wohali/sy99_8mbex/Docs/Schematic v1.1.png

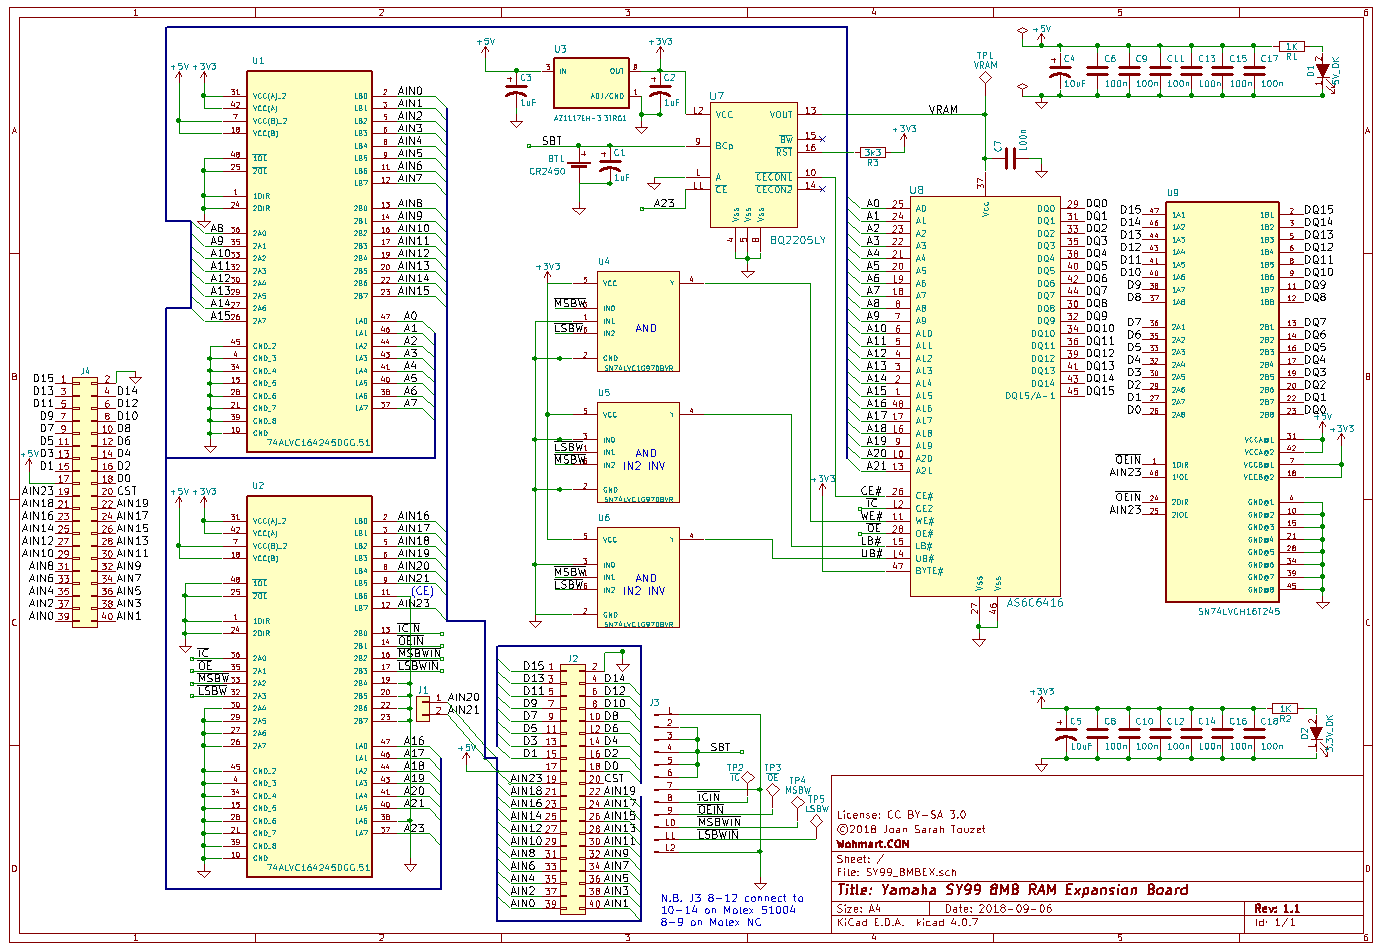
Docs/Schematic v1.1.png
