wohali/sy99_8mbex/Docs/Schematic v1.1.pdf

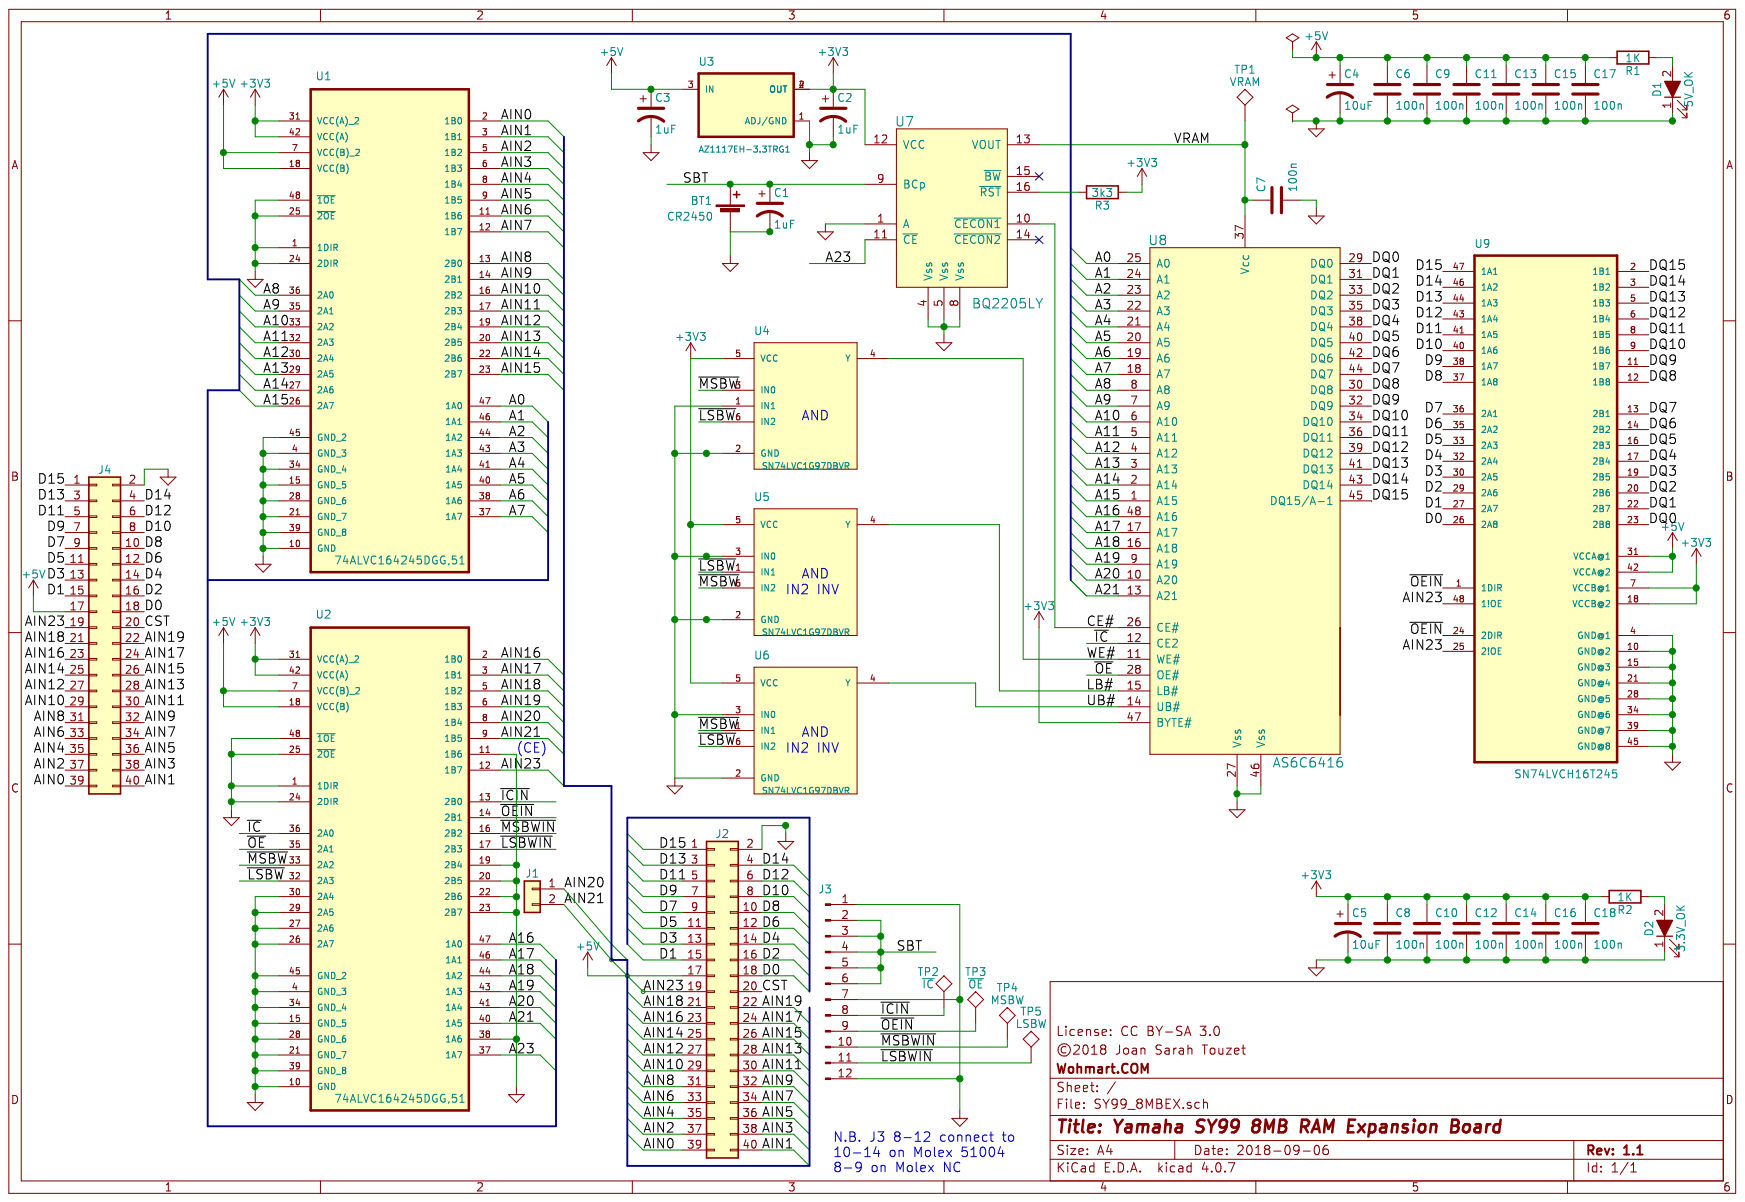
[picture p2: page 1]
