wohali/sy99_8mbex/SY99_8MBEX.kicad_pcb

## KiCad design SY99_8MBEX.kicad_pcb (2018-09-15)

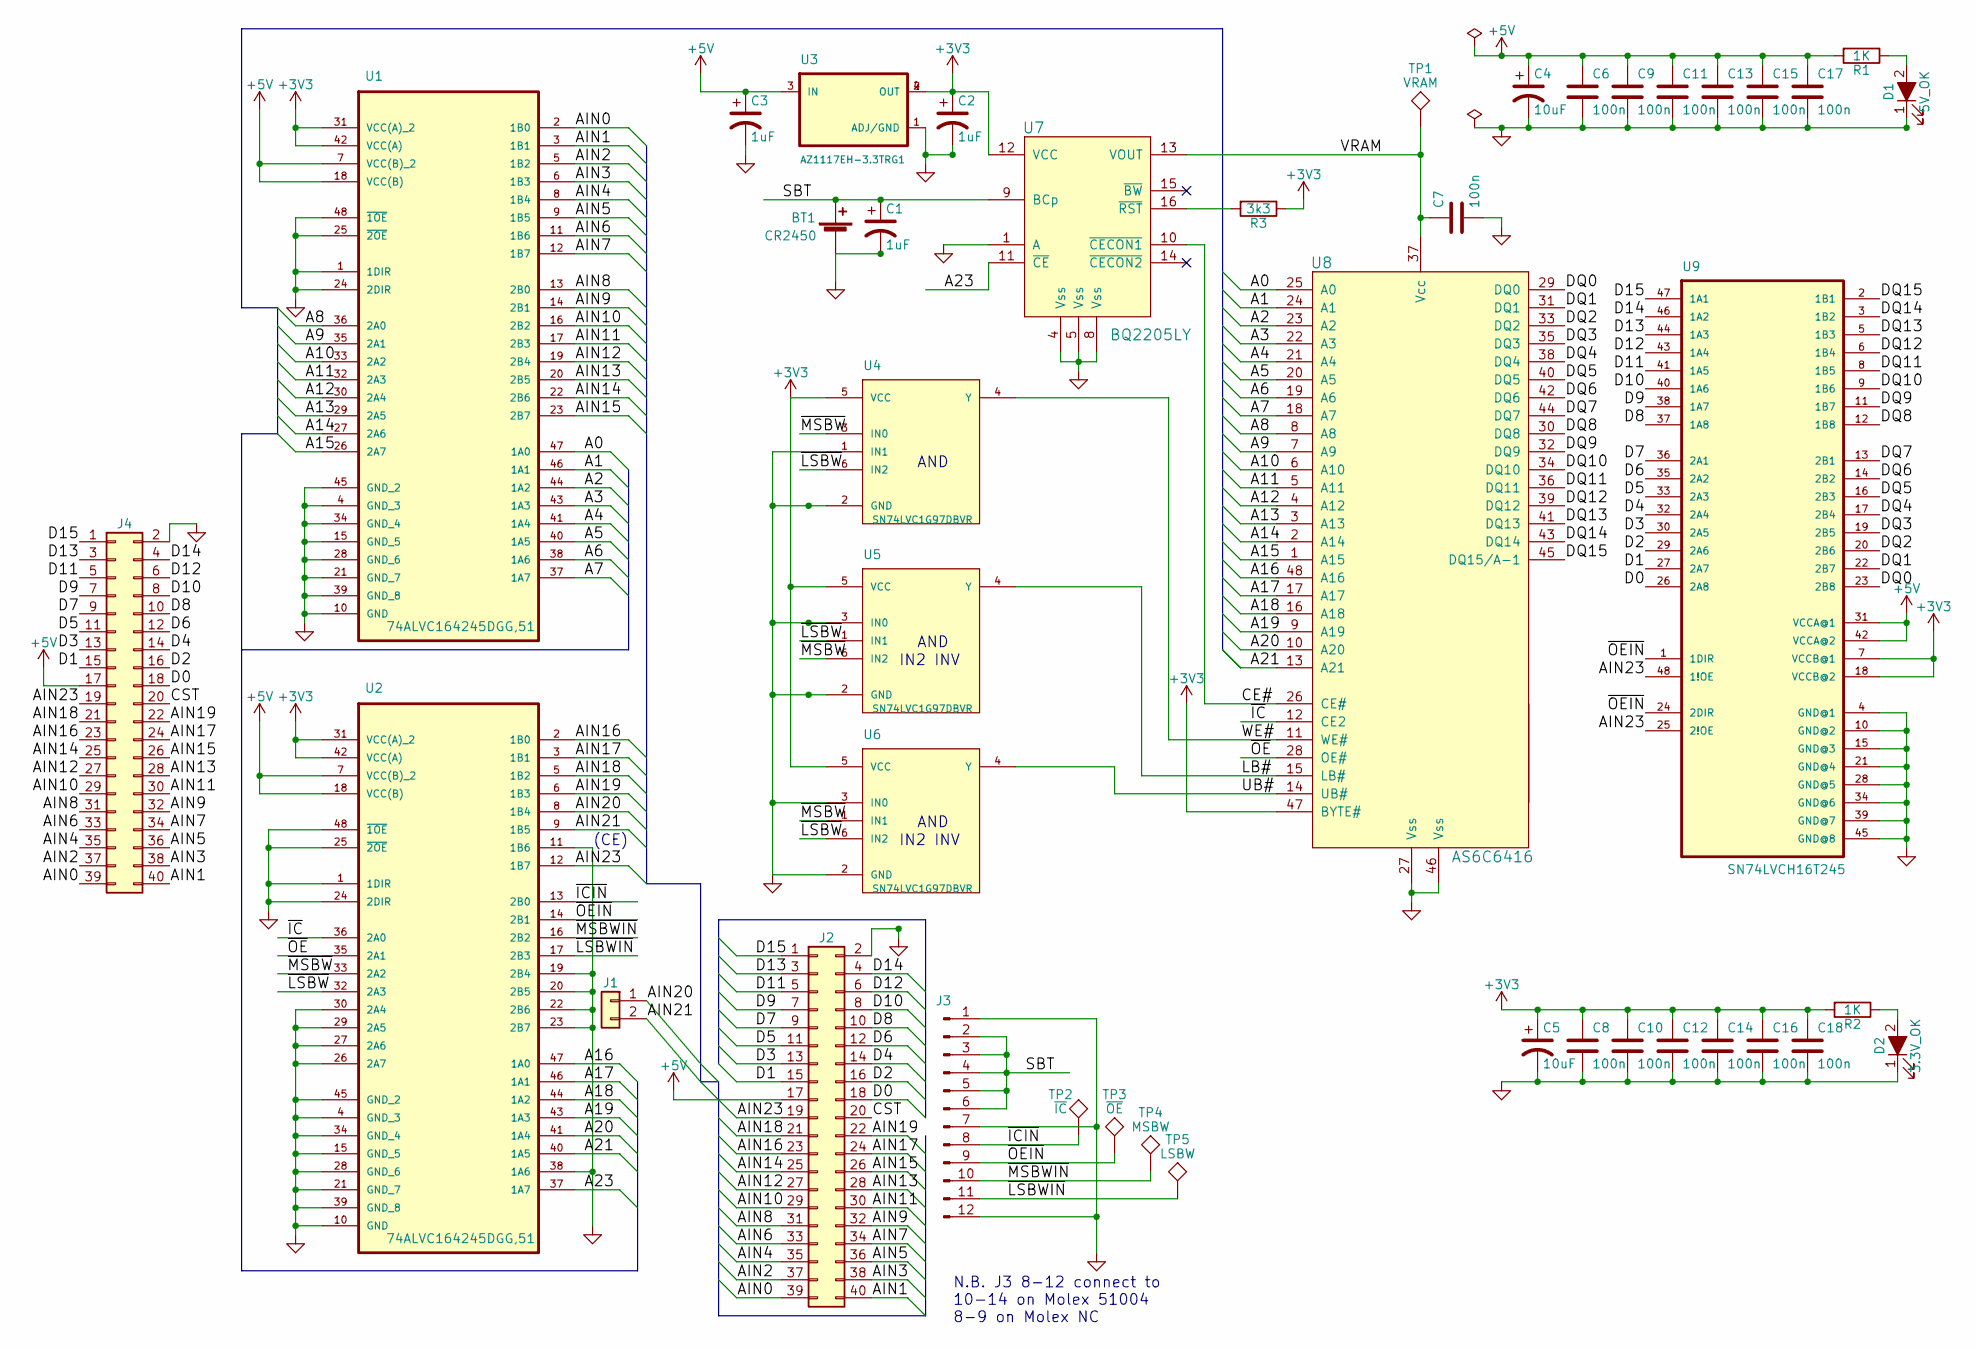
[picture p3: schematic SY99_8MBEX.sch, Yamaha SY99 8MB RAM Expansion Board]

Parts:
BT1: CR2450; Battery_Holder_Coin_2032_BS-7
C1, C2, C3: 1uF; CP_Tantalum_Case-A_EIA-3216-18_Reflow
C4, C5: 10uF; CP_Tantalum_Case-A_EIA-3216-18_Reflow
C6, C7, C8, C9, C10, C11, C12, C13, C14, C15, C16, C17, C18: 100n; C_0805_HandSoldering
D1: 5V_OK; LED_D5.0mm
D2: 3.3V_OK; LED_D5.0mm
J1: Conn_01x02; Pin_Header_Angled_1x02_Pitch2.54mm
J2: Conn_02x20_Odd_Even; Socket_Strip_Straight_2x20_Pitch2.54mm_10.30Wide_SMD
J3: Conn_01x12_Male; Pin_Header_Straight_1x12_Pitch2.54mm
J4: Conn_02x20_Odd_Even; Pin_Header_Straight_2x20_Pitch2.54mm_10.30Wide_SMD
R1, R2: 1K; R_0805_HandSoldering
R3: 3k3; R_0805_HandSoldering
TP1: VRAM; PINTST
TP2: ~IC; PINTST
TP3: ~OE; PINTST
TP4: MSBW; PINTST
TP5: LSBW; PINTST
U1, U2: 74ALVC164245DGG,51; SOP50P810X120-48N
U3: AZ1117EH-3.3TRG1; SOT230P700X180-4N
U4, U5, U6: SN74LVC1G97DBVR; SOT95P280X145-6N
U7: BQ2205LY; SOP65P640X120-16N
U8: AS6C6416; TSOP48
U9: SN74LVCH16T245; TSSOP48

Connections:
+3V3: C2.1, C5.1, C8.1, C10.1, C12.1, C14.1, C16.1, C18.1, R2.2, R3.1, U1.31 (VCC(A)_2), U1.42 (VCC(A)), U2.31 (VCC(A)_2), U2.42 (VCC(A)), U3.2 (OUT), U3.4 (OUT), U4.5 (VCC), U5.5 (VCC), U6.5 (VCC), U7.12 (VCC), U8.47 (BYTE#), U9.7 (VCCB@1), U9.18 (VCCB@2)
+5V: C3.1, C4.1, C6.1, C9.1, C11.1, C13.1, C15.1, C17.1, J2.17, J4.17, R1.2, U1.7 (VCC(B)_2), U1.18 (VCC(B)), U2.7 (VCC(B)_2), U2.18 (VCC(B)), U3.3 (IN), U9.31 (VCCA@1), U9.42 (VCCA@2)
/A0: U1.47 (1A0), U8.25 (A0)
/A1: U1.46 (1A1), U8.24 (A1)
/A2: U1.44 (1A2), U8.23 (A2)
/A3: U1.43 (1A3), U8.22 (A3)
/A4: U1.41 (1A4), U8.21 (A4)
/A5: U1.40 (1A5), U8.20 (A5)
/A6: U1.38 (1A6), U8.19 (A6)
/A7: U1.37 (1A7), U8.18 (A7)
/A8: U1.36 (2A0), U8.8 (A8)
/A9: U1.35 (2A1), U8.7 (A9)
/A10: U1.33 (2A2), U8.6 (A10)
/A11: U1.32 (2A3), U8.5 (A11)
/A12: U1.30 (2A4), U8.4 (A12)
/A13: U1.29 (2A5), U8.3 (A13)
/A14: U1.27 (2A6), U8.2 (A14)
/A15: U1.26 (2A7), U8.1 (A15)
/A16: U2.47 (1A0), U8.48 (A16)
/A17: U2.46 (1A1), U8.17 (A17)
/A18: U2.44 (1A2), U8.16 (A18)
/A19: U2.43 (1A3), U8.9 (A19)
/A20: U2.41 (1A4), U8.10 (A20)
/A21: U2.40 (1A5), U8.13 (A21)
/A23: U2.37 (1A7), U7.11 (~CE)
/AIN0: J2.39, J4.39, U1.2 (1B0)
/AIN1: J2.40, J4.40, U1.3 (1B1)
/AIN2: J2.37, J4.37, U1.5 (1B2)
/AIN3: J2.38, J4.38, U1.6 (1B3)
/AIN4: J2.35, J4.35, U1.8 (1B4)
/AIN5: J2.36, J4.36, U1.9 (1B5)
/AIN6: J2.33, J4.33, U1.11 (1B6)
/AIN7: J2.34, J4.34, U1.12 (1B7)
/AIN8: J2.31, J4.31, U1.13 (2B0)
/AIN9: J2.32, J4.32, U1.14 (2B1)
/AIN10: J2.29, J4.29, U1.16 (2B2)
/AIN11: J2.30, J4.30, U1.17 (2B3)
/AIN12: J2.27, J4.27, U1.19 (2B4)
/AIN13: J2.28, J4.28, U1.20 (2B5)
/AIN14: J2.25, J4.25, U1.22 (2B6)
/AIN15: J2.26, J4.26, U1.23 (2B7)
/AIN16: J2.23, J4.23, U2.2 (1B0)
/AIN17: J2.24, J4.24, U2.3 (1B1)
/AIN18: J2.21, J4.21, U2.5 (1B2)
/AIN19: J2.22, J4.22, U2.6 (1B3)
/AIN20: J1.1, U2.8 (1B4)
/AIN21: J1.2, U2.9 (1B5)
/AIN23: J2.19, J4.19, U2.12 (1B7), U9.25 (2!OE), U9.48 (1!OE)
/CE#: U7.10 (~CECON1), U8.26 (CE#)
/CST: J2.20, J4.20
/D0: J2.18, J4.18, U9.26 (2A8)
/D1: J2.15, J4.15, U9.27 (2A7)
/D2: J2.16, J4.16, U9.29 (2A6)
/D3: J2.13, J4.13, U9.30 (2A5)
/D4: J2.14, J4.14, U9.32 (2A4)
/D5: J2.11, J4.11, U9.33 (2A3)
/D6: J2.12, J4.12, U9.35 (2A2)
/D7: J2.9, J4.9, U9.36 (2A1)
/D8: J2.10, J4.10, U9.37 (1A8)
/D9: J2.7, J4.7, U9.38 (1A7)
/D10: J2.8, J4.8, U9.40 (1A6)
/D11: J2.5, J4.5, U9.41 (1A5)
/D12: J2.6, J4.6, U9.43 (1A4)
/D13: J2.3, J4.3, U9.44 (1A3)
/D14: J2.4, J4.4, U9.46 (1A2)
/D15: J2.1, J4.1, U9.47 (1A1)
/DQ0: U8.29 (DQ0), U9.23 (2B8)
/DQ1: U8.31 (DQ1), U9.22 (2B7)
/DQ2: U8.33 (DQ2), U9.20 (2B6)
/DQ3: U8.35 (DQ3), U9.19 (2B5)
/DQ4: U8.38 (DQ4), U9.17 (2B4)
/DQ5: U8.40 (DQ5), U9.16 (2B3)
/DQ6: U8.42 (DQ6), U9.14 (2B2)
/DQ7: U8.44 (DQ7), U9.13 (2B1)
/DQ8: U8.30 (DQ8), U9.12 (1B8)
/DQ9: U8.32 (DQ9), U9.11 (1B7)
/DQ10: U8.34 (DQ10), U9.9 (1B6)
/DQ11: U8.36 (DQ11), U9.8 (1B5)
/DQ12: U8.39 (DQ12), U9.6 (1B4)
/DQ13: U8.41 (DQ13), U9.5 (1B3)
/DQ14: U8.43 (DQ14), U9.3 (1B2)
/DQ15: U8.45 (DQ15/A-1), U9.2 (1B1)
/LB#: U5.4 (Y), U8.15 (LB#)
/SBT: BT1.1 (+), C1.1, J3.2, J3.3, J3.4, J3.5, J3.6, U7.9 (BCp)
/UB#: U6.4 (Y), U8.14 (UB#)
/VRAM: C7.1, TP1.1, U7.13 (VOUT), U8.37 (Vcc)
/WE#: U4.4 (Y), U8.11 (WE#)
/~IC: U2.36 (2A0), U8.12 (CE2)
/~ICIN: J3.8, TP2.1, U2.13 (2B0)
/~LSBW: U2.32 (2A3), U4.6 (IN2), U5.1 (IN1), U6.6 (IN2)
/~LSBWIN: J3.11, TP5.1, U2.17 (2B3)
/~MSBW: U2.33 (2A2), U4.3 (IN0), U5.6 (IN2), U6.1 (IN1)
/~MSBWIN: J3.10, TP4.1, U2.16 (2B2)
/~OE: U2.35 (2A1), U8.28 (OE#)
/~OEIN: J3.9, TP3.1, U2.14 (2B1), U9.1 (1DIR), U9.24 (2DIR)
GND: BT1.2 (-), C1.2, C2.2, C3.2, C4.2, C5.2, C6.2, C7.2, C8.2, C9.2, C10.2, C11.2, C12.2, C13.2, C14.2, C15.2, C16.2, C17.2, C18.2, D1.1 (K), D2.1 (K), J2.2, J3.1, J3.7, J3.12, J4.2, U1.1 (1DIR), U1.4 (GND_3), U1.10 (GND), U1.15 (GND_5), U1.21 (GND_7), U1.24 (2DIR), U1.25 (~2OE), U1.28 (GND_6), U1.34 (GND_4), U1.39 (GND_8), U1.45 (GND_2), U1.48 (~1OE), U2.1 (1DIR), U2.4 (GND_3), U2.10 (GND), U2.11 (1B6), U2.15 (GND_5), U2.19 (2B4), U2.20 (2B5), U2.21 (GND_7), U2.22 (2B6), U2.23 (2B7), U2.24 (2DIR), U2.25 (~2OE), U2.26 (2A7), U2.27 (2A6), U2.28 (GND_6), U2.29 (2A5), U2.30 (2A4), U2.34 (GND_4), U2.38 (1A6), U2.39 (GND_8), U2.45 (GND_2), U2.48 (~1OE), U3.1 (ADJ/GND), U4.1 (IN1), U4.2 (GND), U5.2 (GND), U5.3 (IN0), U6.2 (GND), U6.3 (IN0), U7.1 (A), U7.4 (Vss), U7.5 (Vss), U7.8 (Vss), U8.27 (Vss), U8.46 (Vss), U9.4 (GND@1), U9.10 (GND@2), U9.15 (GND@3), U9.21 (GND@4), U9.28 (GND@5), U9.34 (GND@6), U9.39 (GND@7), U9.45 (GND@8)
unnamed: D1.2 (A), R1.1
unnamed: D2.2 (A), R2.1
unnamed: R3.2, U7.16 (~RST)

Notes on the sheet:
(CE)
AND
IN2 INV
N.B. J3 8-12 connect to 10-14 on Molex 51004 8-9 on Molex NC

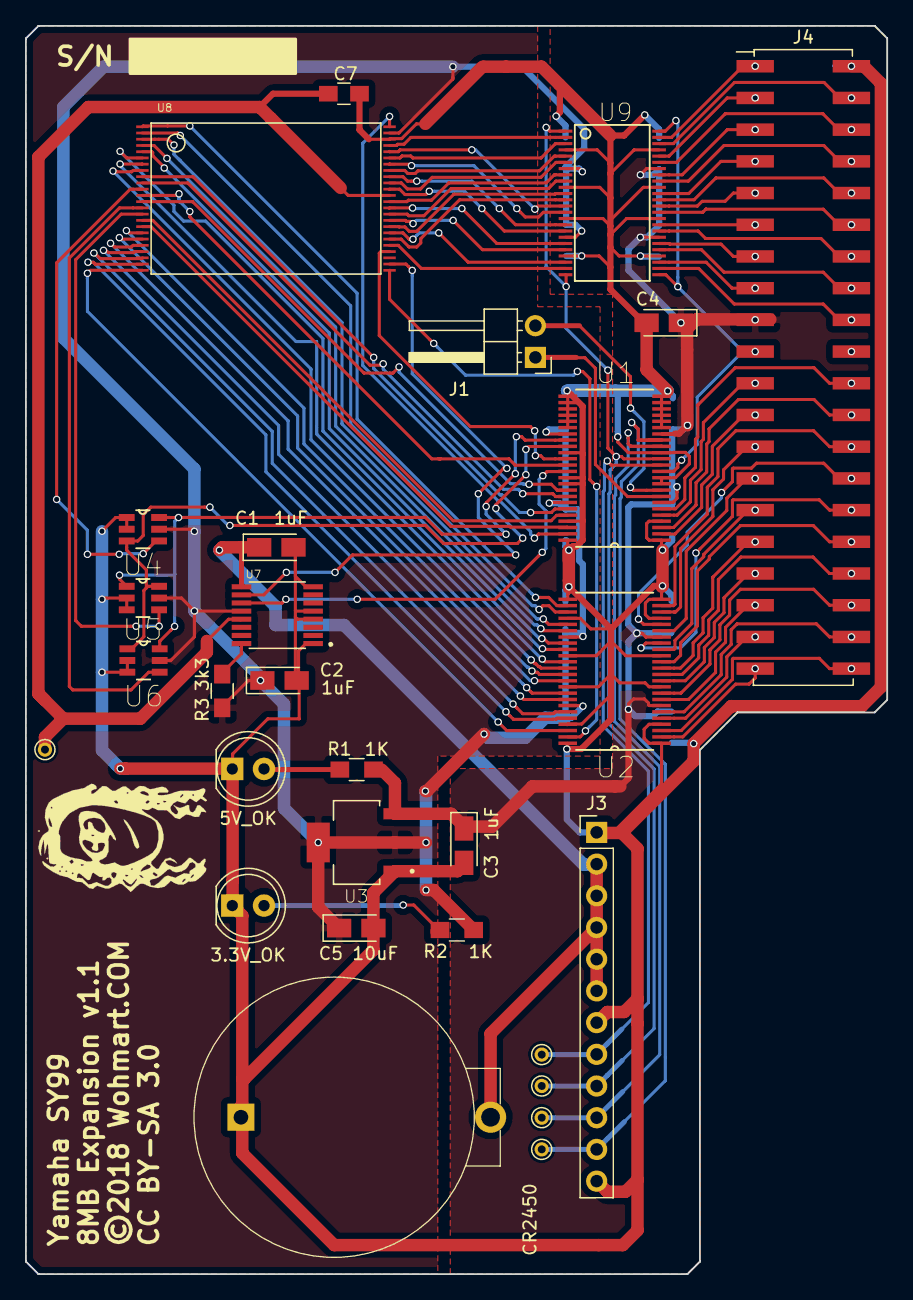
[picture p4: board SY99_8MBEX.kicad_pcb from above]

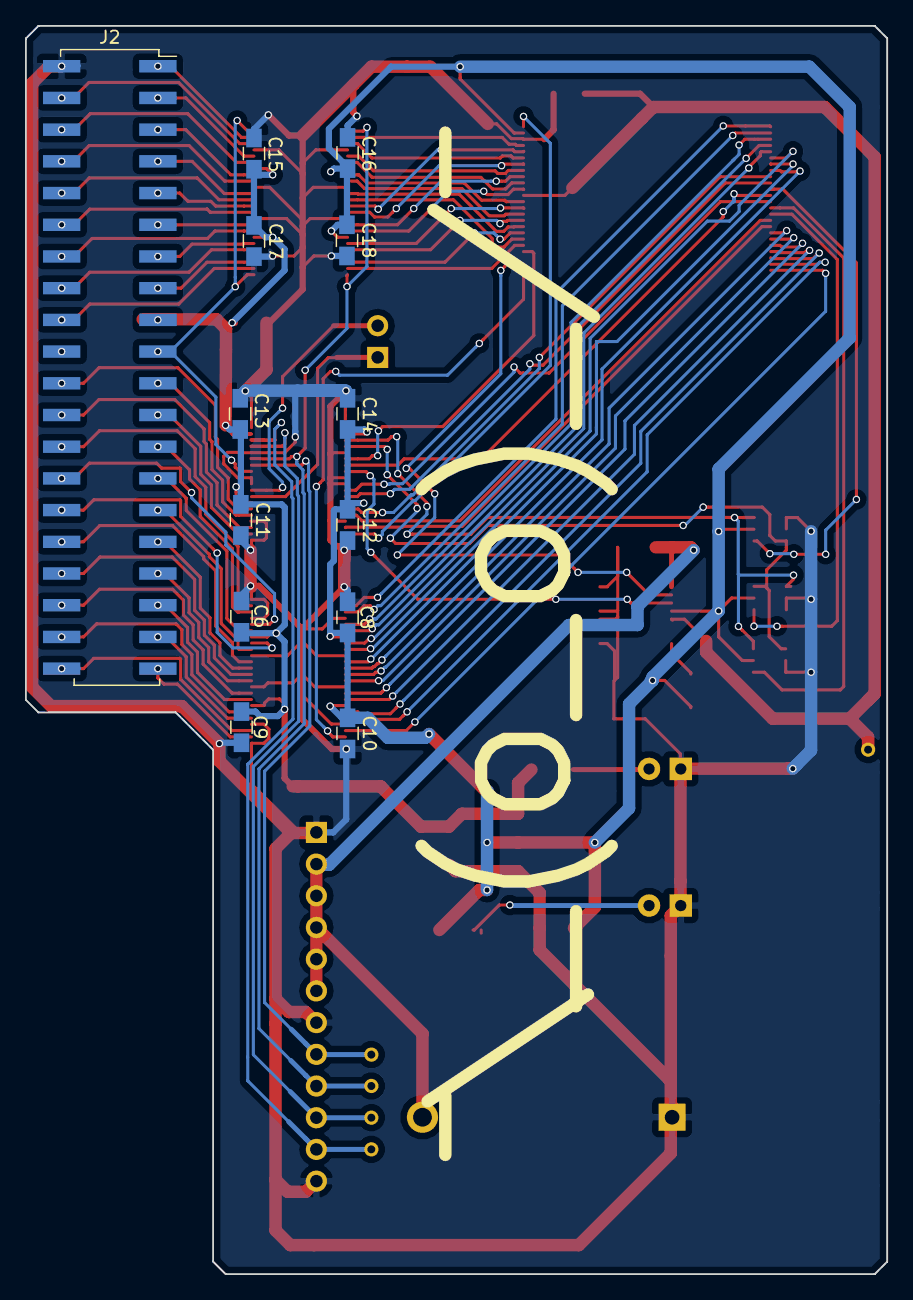
[picture p5: board SY99_8MBEX.kicad_pcb from below]

Board: 2 copper layers, 69.0 x 100.0 mm, 42 parts (13 on the bottom side), 99 nets.
