wohali/sy99_8mbex/(commit log)

2018-08-28 Version 1.0
    [SY99_8MBEX.kicad_pcb, SY99_8MBEX.sch]
2018-09-15 Version 1.1
    [SY99_8MBEX.kicad_pcb, SY99_8MBEX.sch]
2018-09-15 Add missing BOM
    [bom.csv]
2018-09-15 fix missing comma in bom
    [bom.csv]
