wohali/sy99_8mbex/(notices)

Notices in the files:
SY99_8MBEX.kicad_pcb:
©2018 Wohmart.COM
CC BY-SA 3.0
SY99_8MBEX.sch:
©2018 Joan Sarah Touzet
